Grigoriym/esp32-mukklet/enclosure/pages/knob/v1-hooks.png

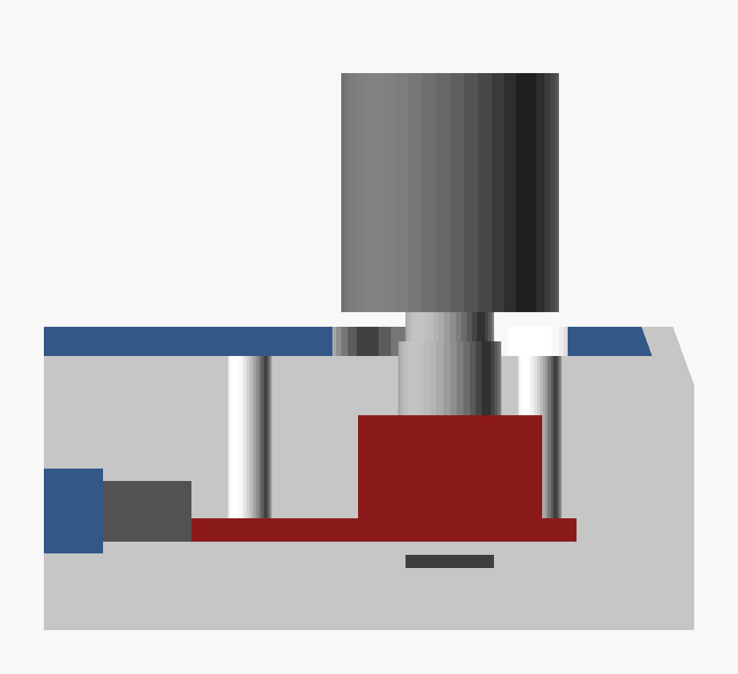
enclosure/pages/knob/v1-hooks.png
