Grigoriym/esp32-mukklet/enclosure/pages/knob/v2-knob.png

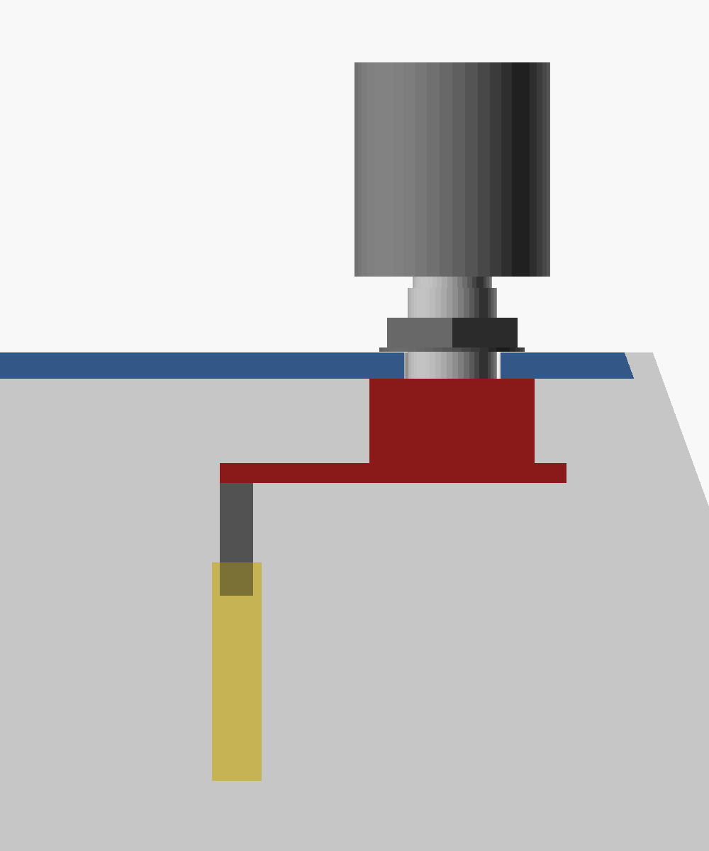
enclosure/pages/knob/v2-knob.png
