Grigoriym/esp32-mukklet/enclosure/pages/knob/v2-nut.png

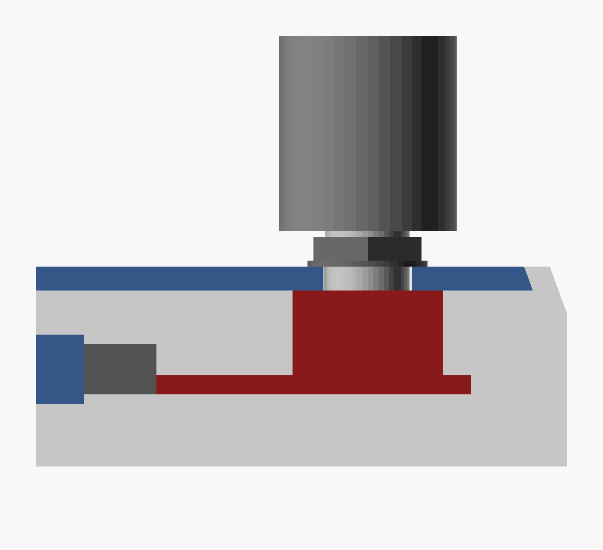
enclosure/pages/knob/v2-nut.png
