Grigoriym/esp32-mukklet/(list of files, cad)

Other CAD files:
enclosure/archive/v1/enclosure.scad
