Grigoriym/esp32-mukklet/enclosure/pages/assembly/assembly.html

# How the Mukklet case goes together

The case is three printed parts: a body, a front plate with the screen, and a floor plate with the ESP32 board. Pictures are from the case model; the screws are not drawn.

bodyfront platefloor plateESP32 boardplugs on the pins

1

## Three parts

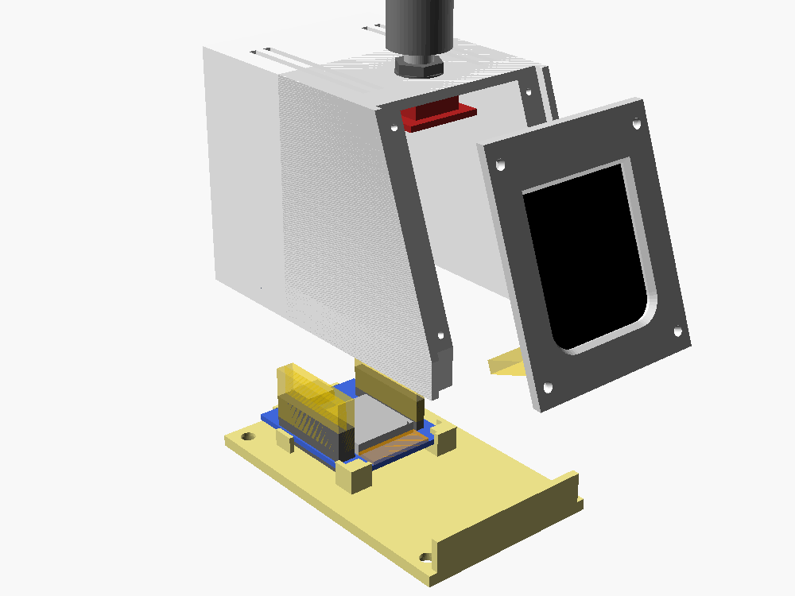
[picture p10: enclosure/pages/assembly/s1.png]
The body lifted above the floor plate, the front plate with the screen pulled forward


The body is the walls, the top and the back. The front plate carries the screen. The floor plate carries the ESP32 board and the low strip under the screen. The knob goes into the body.

2

## Screw the screen onto the front plate

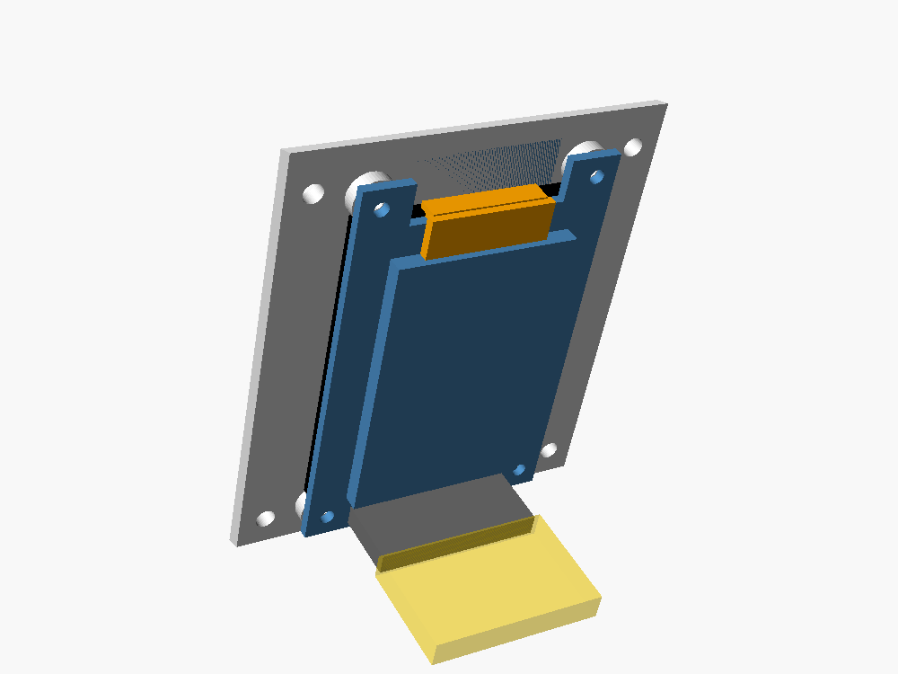
[picture p11: enclosure/pages/assembly/s2.png]
The front plate seen from behind, the screen board on its four posts, its plug hanging down


Lay the plate face down on the desk and put the screen on it, glass down, pins at the bottom. Four short screws go through the board's corner holes into the posts. Then push the cable's plug onto the pins.

3

## Bolt the knob into the body

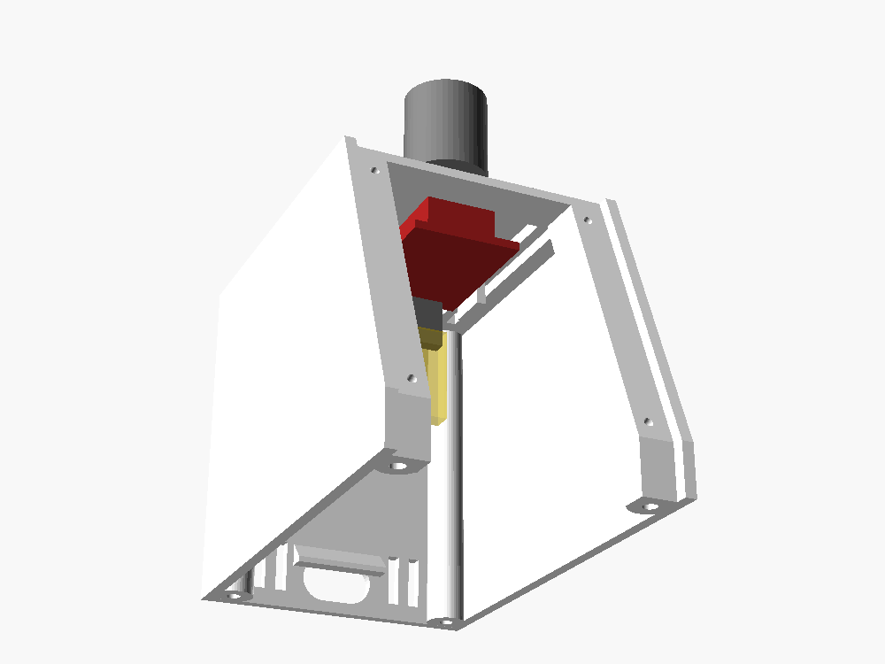
[picture p12: enclosure/pages/assembly/s3.png]
The body seen from below and in front, the knob board under the top


Reach in through the open front and push the knob's threaded collar up through the small hole in the top, the board between the two ribs. From outside, put on the washer and screw the nut down. Then press the cap onto the shaft. The two rails are what the front plate will lie on.

4

## Screw the front plate onto the body

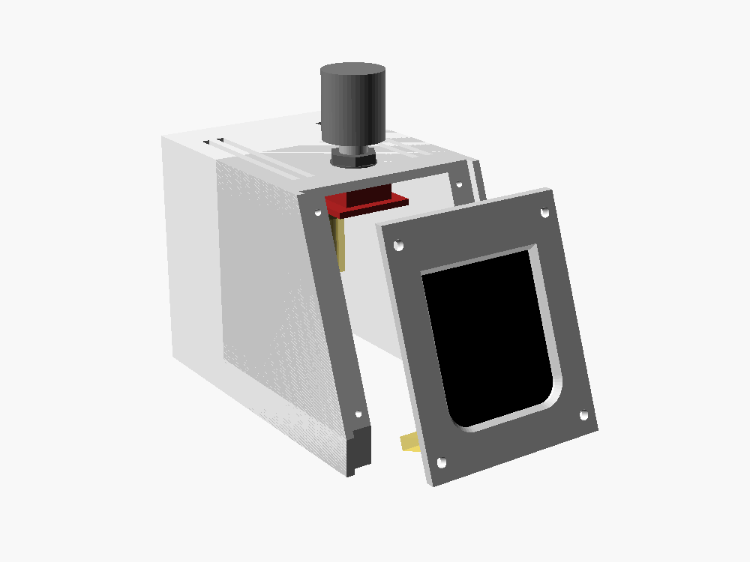
[picture p13: enclosure/pages/assembly/s4.png]
The front plate with the screen held in front of the body's open front


The plate drops in between the two side walls and lies on the rails. Four screws go in from the front, one at each corner; their heads stay visible.

5

## Slide the board under the two tabs

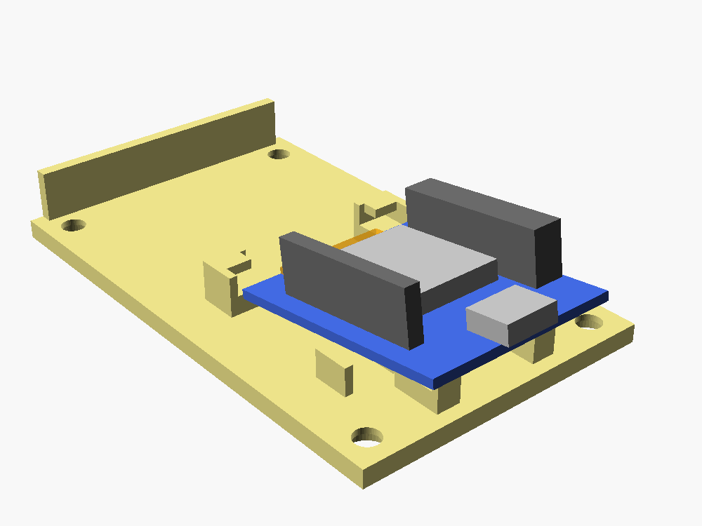
[picture p14: enclosure/pages/assembly/s5.png]
The board held at a slight tilt, about to slide under two tabs on the floor plate


The floor plate lies on the desk, on its own. Hold the board with the USB end a little higher and slide the other end forward, under the two tabs.

6

## Lay the board flat and plug in the cables

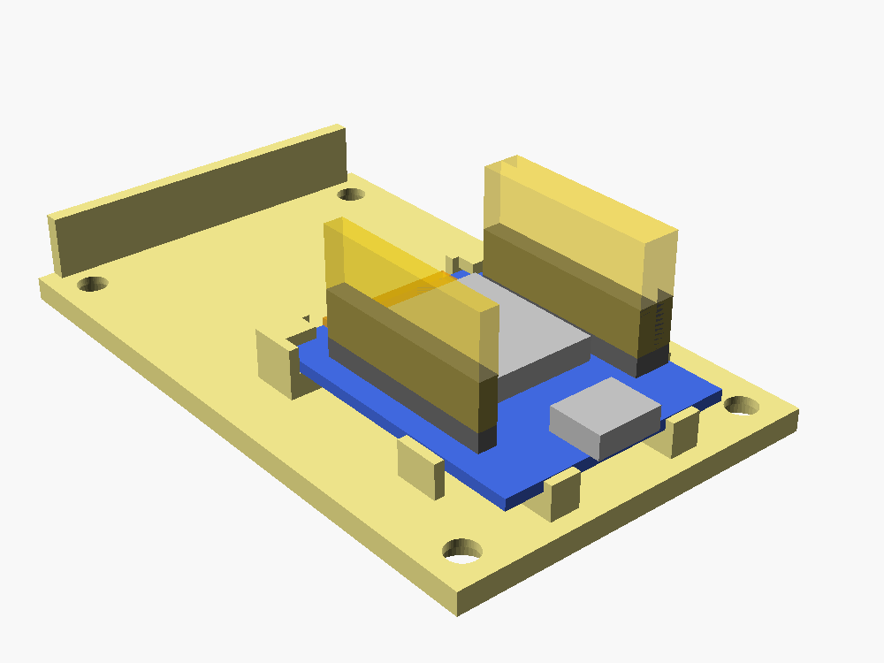
[picture p15: enclosure/pages/assembly/s6.png]
The board lying flat on the floor plate with plugs on its pins


Lower the USB end until the board lies flat. Two small blocks behind it stop it sliding back. Then push the screen's and the knob's plugs onto the pins.

7

## Put the body over it and screw it shut

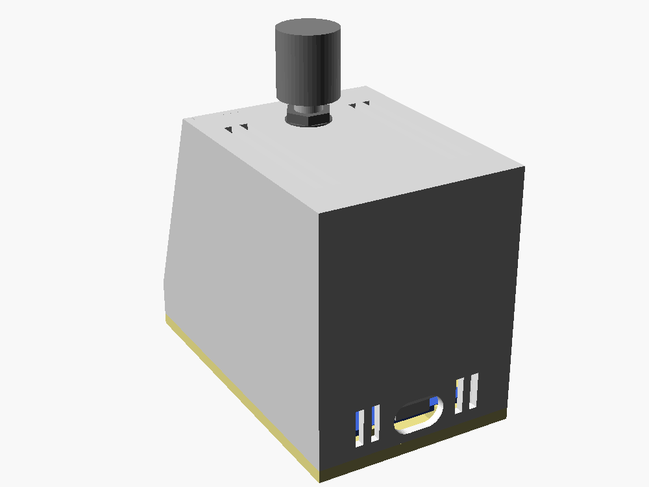
[picture p16: enclosure/pages/assembly/s7.png]
The closed case from the back, the USB socket visible in its hole


Lower the body over the floor plate and put in 4 screws (M3 x 10) from underneath. The USB socket ends up behind the hole in the back.

8

## Why the board can't move

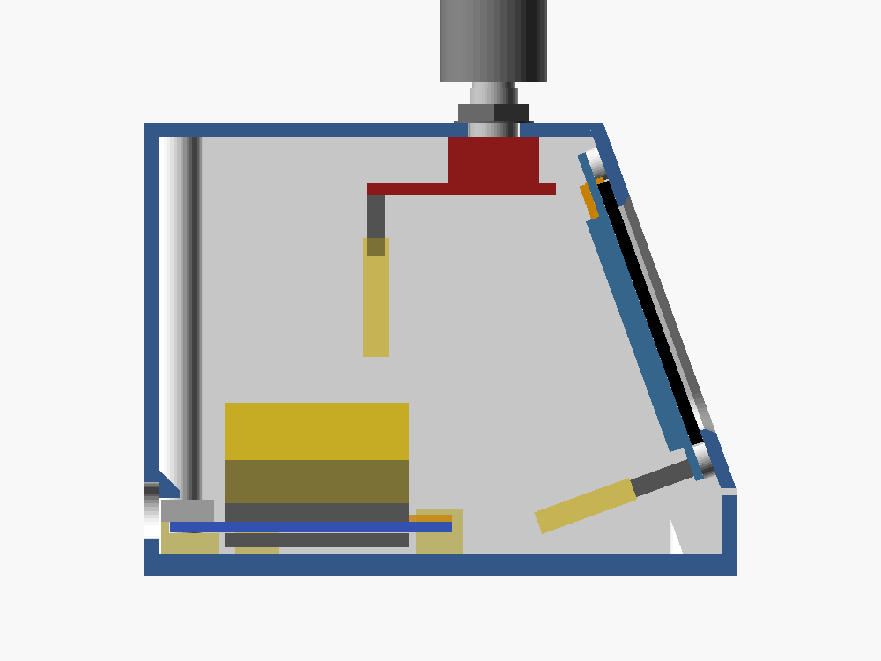
[picture p17: enclosure/pages/assembly/s8.png]
The closed case cut through the middle, seen from the side


This is the closed case cut through the middle. At the front end of the board, the tabs hold it down. At the back end, a small ledge inside the body sits just above the USB socket. Nothing clicks and nothing is glued.
