Grigoriym/esp32-mukklet/enclosure/pages/assembly/base-v2/corner-closeup.png

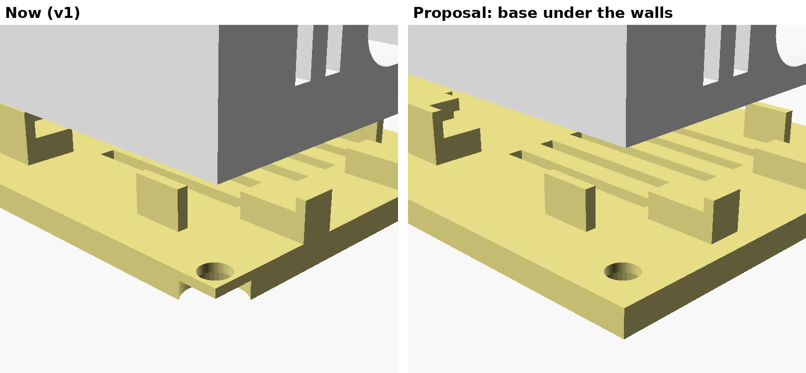
enclosure/pages/assembly/base-v2/corner-closeup.png
