Grigoriym/esp32-mukklet/enclosure/pages/assembly/base-v2/exploded-back.png

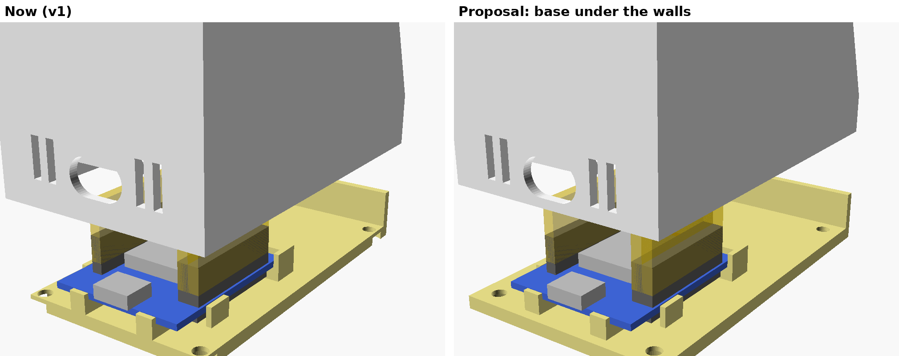
enclosure/pages/assembly/base-v2/exploded-back.png
