Grigoriym/esp32-mukklet/(commit log)

2026-09-27 Mukklet firmware, milestone 1: text now-playing display for Mukk
    ESP32 + 128x64 OLED + KY-040 knob. Serves ws://mukklet.local/ws
    (docs/PROTOCOL.md), shows title/artist/album/next/progress/volume and sends
    knob commands (turn = volume, press = play/pause, double = next, long =
    prev). Cover art not requested yet (hello asks for format "none").
    - 6x10 font generated from X11 misc-fixed: Latin-1/2/9/13/15 + Cyrillic
    - pure, host-tested modules: proto, player, ui, fb, font, gesture
    - tools/fake_mukk.py plays Mukk's role; fake_display.py plays the ESP32's
    - CI: build, flash budget, formatting, host tests, clang-tidy
    [display.c, display.h, encoder.c, encoder.h, fake_display.py, fake_mukk.py, gesture.c, gesture.h]
2026-09-27 CLAUDE.md: no cover art on the OLED prototype
2026-09-27 CLAUDE.md: GERUI screen driver is ST7789V2
2026-09-28 Move to the ST7789 colour screen (text only)
    Replaces the OLED with the 1.69" 240x280 ST7789V2: esp_lcd driver drawing
    in 20-row strips (only changed strips are sent), an RGB565 band canvas,
    anti-aliased DejaVu Sans fonts and a 240x280 layout with a placeholder
    for the cover. hello still asks for no cover.
    [display.c, display.h, main.c, proto.c, proto.h, ui.c, ui.h]
2026-09-28 CLAUDE.md: cover art verified on the board with the real Mukk
2026-09-28 PROTOCOL: send cover only when the track id or art changed
2026-09-28 Nothing playing: the bored eyes too
    ui_screen() names the screen; main.c restarts the eyes' cycle whenever it
    changes, so Mukk connecting with no track starts them fresh.
2026-09-29 Enclosure: first draft OpenSCAD model, export with clash check, TFT measurement list
    Wedge 50 x 82 x 62: portrait TFT on a 20-degree panel (4 screw posts),
    knob on top, ESP32 on a 40 x 44 perfboard carrier, USB-C out the back.
    Lifted from the desk display's enclosure_v2 (cut carrier). TFT sizes are
    the seller's until measured (MEASUREMENTS.md).
    [enclosure.scad]
2026-09-29 Enclosure: TFT board measured (31.22 x 48.01), ears + flex notch at the top, header on the back
    [enclosure.scad]
2026-09-29 Enclosure: TFT thickness measured (2.92 total, board 1.21)
    [enclosure.scad]
2026-09-29 Enclosure: TFT glass measured (30.06 x 37.43)
    [enclosure.scad]
2026-09-29 Enclosure: TFT stand-in gets the ears, the notch and the flat cable
    Notch ~19 x 4.7 and cable read off the photos until measured.
    [enclosure.scad]
2026-09-29 Enclosure: TFT glass top gap measured (4.73), top posts slimmed to 4 mm to clear it
    The bottom gap (4.94) leaves 0.91 unaccounted for against 48.01: rechecking.
    [enclosure.scad]
2026-09-29 Enclosure: TFT glass position settled (4.73..43.13 from the ear tops), height 47.96
    [enclosure.scad]
2026-09-29 Enclosure: fix glass height using tft_glass_top before its definition; export.sh fails on such warnings
    [enclosure.scad]
2026-09-29 Enclosure: TFT notch measured (18.91 x 5.13)
    [enclosure.scad]
2026-09-29 Enclosure: window sized from the glass (0.5 mm lip), pixel-area position not measured
    [enclosure.scad]
2026-09-29 Enclosure: TFT hole size measured (1.79, likely 2.0)
    [enclosure.scad]
2026-09-29 Enclosure: TFT hole spacing measured (26.19 x 42.91)
    [enclosure.scad]
2026-09-29 Enclosure: TFT posts flattened on the glass side (0.3 clear), back to 4.5 mm
    [enclosure.scad]
2026-09-29 Enclosure: TFT header taken as a standard one (8.5 from the back)
    [enclosure.scad]
2026-09-29 Enclosure: TFT measuring done, the rest from photos and standard parts
    [enclosure.scad]
2026-09-30 Enclosure: TFT screws are M2 x 4 (an M2 x 6 would poke out of the front)
    [enclosure.scad]
2026-09-30 Enclosure: carrier and base on M3 from the user's kit; only the TFT needs M2
    [enclosure.scad]
2026-09-30 Enclosure README: TFT screws are M2 x 4 machine screws from an M2 kit
2026-09-30 Enclosure README: TFT screws are M2 x 4 self-tapping from a small pan-head kit
2026-09-30 Enclosure: cardboard mock-up templates (cardboard.py, 1:1 A4 PDF from the model)
    [enclosure.scad]
2026-09-30 CLAUDE.md: enclosure next step (cardboard mock-up), screws
2026-09-30 Enclosure: EPLZON 38.1 x 50.8 breadboard-style carrier, no JST sockets, case 89 deep
    ESP32 headers in columns A and I (10 pitches, its pin rows), module wires
    soldered into the joined rows. 88 is the minimum depth (TFT plug in front,
    back bosses behind); 89 leaves 1 mm.
    [enclosure.scad]
2026-09-30 Enclosure: back to 82 deep with the EPLZON carrier, 9 mm up over the TFT plug
    Front fixing moves to its M2 corner holes (the plug is under the front
    middle hole). Keeps the size of the cardboard mock-up already built.
    [enclosure.scad]
2026-09-30 CLAUDE.md: enclosure lessons and where it's paused (mock-up built, EPLZON holes to check, screws)
2026-09-30 ESP32 mini (D1 mini layout, CH9102F) ordered for the enclosure: same pins, wires soldered to its pads, no carrier
    docs/WIRING.md: full pin table, plus which mini pad each wire goes to.
2026-10-01 ESP32 mini arrived: measurements, pins-up wiring plan
2026-10-01 ESP32 mini: pin hole positions (approximate)
2026-10-01 Enclosure: ESP32 mini in a cradle on the base, ledge over its USB socket; carrier and DevKit out
    [enclosure.scad]
2026-10-01 Enclosure: exploded and tilt-in assembly views (explode, mini_tilt, mini_back)
    [enclosure.scad]
2026-10-01 Finalize: artifact sources in the repo, serial_log.py PORT, enclosure lessons
2026-10-02 Enclosure in three parts: body, front plate, base; pins moved for the mini
    The TFT's two top screws could not be reached in the one-piece shell, so
    the screen panel is now a flat plate screwed on from the front, and the
    strip under the screen moved to the base. Vent slots mirrored. Knob on
    27/25/32 and BLK on 19, as wired on the mini.
    [enclosure.scad]
2026-10-02 Enclosure pages: local HTML instead of artifacts, assembly redone for three parts
    [enclosure.scad]
2026-10-02 export.sh: stl folder holds only the parts to print, test piece in optional/
2026-10-02 Front plate: 0.8 mm straight edge at the window instead of a knife edge
    [enclosure.scad]
2026-10-02 Front plate: 1.2 mm window edge, cleaner window cut, 5.5 mm TFT posts
    [enclosure.scad]
2026-10-02 Notes: the front plate passes hubs.com's check
    [enclosure.scad]
2026-10-02 Finalize: print ordered, assembly render script, notes brought up to date
2026-10-02 Docs: part facts and generic lessons now point to grappim-watcher/docs/esp32
    Part specs, dimensions, board MACs and ports, the mini's pad layout, the
    unusable-GPIO list and the generic enclosure and flash lessons moved to
    the shared sheets; this repo keeps its pin and housing tables, decisions,
    milestones and the case design. New rule in CLAUDE.md: a new fact about a
    part goes in its sheet there.
2026-10-03 Notes: point to the shared esp32-flash-verify skill
2026-10-03 Docs: part facts now live only in Homebox
    The shared part sheets in grappim-watcher were merged into the Homebox
    inventory and deleted (one source of truth per fact). Repoint CLAUDE.md,
    docs/WIRING.md and enclosure/ to parts.py show, and drop the part facts
    this repo still repeated.
2026-10-03 Enclosure README: the screw kits' contents are in Homebox
2026-10-07 Enclosure: v1 print findings and the v2 list
2026-10-07 CLAUDE.md: v1 case printed, next steps after the print
2026-10-10 Enclosure README: front screws snapped in the rails, v2 fix
2026-10-10 Enclosure README: front plate on 2 x 6 screws, v2 pilots to match
2026-10-10 Enclosure README: 2 x 6 screws in all four front holes
2026-10-10 Enclosure: renders of the base-under-the-walls proposal for v2
2026-10-10 Enclosure: base over the whole footprint, walls stand on it
    The base sat inside the walls, so its screw holes were 2.2 from its edge
    (0.2 once drilled to 4) and the head counterbores broke out of it. Now
    the base covers 50 x 82 and the body's walls stop 3 mm higher; outside
    size unchanged. Also base holes 4.0 and boss pilots 13 deep (the screw's
    tip reached 0.7 past the old 11).
    [enclosure.scad]
2026-10-10 Enclosure: knob guide page, the nut mount idea and what to measure
2026-10-10 Enclosure v2: knob held by its own nut, front plate on 2 x 6 screws
    The KY-040's M7 collar goes up through a 7.3 hole; its nut and washer
    clamp the encoder body against the inside of the top (measured: collar
    6.73 x 6.86, body 6.38, board 1.47, nut 2.24, washer 0.37). Two ribs at
    the pin end stop it turning. Replaces v1's snap hooks, one of which
    didn't catch. Header now straight down under the pin end. Front plate:
    2.4 holes, 1.6 pilots 6 deep for 2 x 6 screws.
    [enclosure.scad]
2026-10-10 Enclosure: v1 (as printed) moved to archive/v1, main docs show v2 only
    [enclosure.scad]
2026-10-10 Window: top edge 3.4 lower, bottom 1.05 higher; EDGE_TEST screen
    On v1 every edge pixel showed but black glass showed round them: 3.6 at
    the top (flat cable side), 1.25 at the bottom, measured with the new
    EDGE_TEST screen (coloured 2 px frames from the edges). v2's window stops
    0.2 outside the pixels at top and bottom.
    [enclosure.scad]
2026-10-10 Window: bottom corners rounded r 5 like the pixel area; corner test screen
    EDGE_TEST 2 draws quarter circles of 10..45 px in the bottom corners;
    on the panel a 40 px arc was just cut and 45 px whole: ~42 px, 4.9 mm.
    [enclosure.scad]
2026-10-10 Base: strip under the screen 0.8 lower, 1.0 below the front plate
    On v1 the plate, once screwed on, sat on the strip and the base wouldn't
    go fully in at the front.
    [enclosure.scad]
2026-10-10 Enclosure: pre-print checks in the model and export.sh; front screws 0.5 in
    The model asserts edge distance round holes, pilot depth against each
    screw's reach, the plate-strip gap and thread above the knob nut;
    export.sh fails on them, prints the margins and lists every ASSUMED
    value. The front plate's screws move 0.5 inwards: 1.5 mm of plate beside
    their holes was below the 2 mm rule.
    [enclosure.scad]
2026-10-10 CLAUDE.md: v2 sent to print, pre-print review, window test screens
2026-10-16 enclosure.scad: header comment says ribs, not v1's snap hooks
2026-10-16 CLAUDE.md: case v2 printed and assembled
2026-10-16 CLAUDE.md: case v2 window checked with both edge test screens
2026-10-16 v1 notes: printed in PETG
